jackbh510/IEEE-Audio-Equalizer/Baxandall Tone Circuit Test.asc

C1: cap; 22n
C2: cap; 22n
C3: cap; 1.8n
C4: cap; 220p
R1: res; 5.6k
R2: res; 5.6k
R3: res; {pot1*pot1dev/100}
R4: res; {pot1-pot1*pot1dev/100}
R5: res; 10k
R6: res; 100k
R7: res; {pot2*pot2dev/100}
R8: res; {pot2-pot2*pot2dev/100}
R9: res; 3.3k
R10: res; 3.3k
U1: ADTL082
V1: voltage; ""; AC 1
V2: voltage; 9
V3: voltage; -9
Named nets: 0
.param pot1 100k
;.param pot1dev=1
.param pot2 100k
;.param pot2dev=1
.ac dec 100 10 100k
Output
.step param pot2dev 1 99 10
.step param pot1dev 1 99 10
