jackbh510/IEEE-Audio-Equalizer/LCCircuit.asc

C1: cap; .32µ
C2: cap; 1.308µ
C3: cap; .09µ
C4: cap; 6.8µ
C5: cap; 1µ
C6: cap; 1µ
C7: cap; 1n
L1: ind; 22m; Rser=18
L2: ind; 100m; Rser=82
L3: ind; 4.7m; Rser=7.6
R1: res; 1.8k
R2: res; 1.8k
R3: res; 100
R4: res; {pot1-pot1*pot1dev/100}
R5: res; 155
R6: res; {pot1*pot1dev/100}
R7: res; {pot2*pot2dev/100}
R8: res; {pot2-pot2*pot2dev/100}
R9: res; 180
R10: res; {pot3*pot3dev/100}
R11: res; {pot3-pot3*pot3dev/100}
R12: res; 1.8k
R13: res; 1.8k
R14: res; 8k
R15: res; 8k
R16: res; {pot4*pot4dev/100}
R17: res; 8k
R18: res; 8k
R19: res; {pot4-pot4*pot4dev/100}
R20: res; 150
R21: res; 1.8k
R22: res; 1.8k
R23: res; 680
R24: res; 680
R25: res; 680
R26: res; 680
R27: res; 470
R28: res; 100k
R29: res; 1k
U1: UniversalOpAmp2
U2: UniversalOpAmp2
U3: UniversalOpAmp2
U4: UniversalOpAmp2
U5: UniversalOpAmp2
U6: UniversalOpAmp2
U7: UniversalOpAmp2
U8: UniversalOpAmp2
U9: UniversalOpAmp2
V1: voltage; ""; AC 1
V2: voltage; -16
V3: voltage; 16
Named nets: 0, Vout, 16V, -16V, AC_Input, Vin, Summing_Node, Gyr_Induced_L, Low_Pass
.ac dec 100 10 100k
.param pot1=10k
.param pot1dev=50
;.step param pot1dev 1 99 10
.param pot2=10k
;.step param pot2dev 1 99 10
.param pot2dev=50
.param pot3=10k
.param pot3dev=50
;.step param pot3dev 1 99 10
.param pot4=10k
.param pot4dev=50
;.step param pot4dev 1 99 10
