jackbh510/IEEE-Audio-Equalizer/AudioEqualizerLTSpice/Equalizer/LCCircuit.asc

C1: cap; .33µ
C2: cap; 1µ
C3: cap; .068µ
C4: cap; 1µ
C5: cap; 1µ
C6: cap; 1µ
C7: cap; 1n
C8: polcap; 2200µ
C9: polcap; 2200µ
C10: cap; .1µ
C11: cap; .1µ
C12: polcap; 10µ
C13: polcap; 10µ
C14: cap; .33µ
C15: cap; .022µ
D1: diode; 1N5819
D2: diode; 1N5819
D3: diode; 1N4007
D4: diode; 1N4007
L1: ind; 22m; Rser=80
L2: ind; 100m; Rser=82
L3: ind; 4.7m; Rser=13.6
R1: res; 1.87k
R2: res; 1.87k
R3: res; 100
R4: res; {pot1-pot1*pot1dev/100}
R5: res; 100
R6: res; {pot1*pot1dev/100}
R7: res; {pot2*pot2dev/100}
R8: res; {pot2-pot2*pot2dev/100}
R9: res; 150
R10: res; {pot3*pot3dev/100}
R11: res; {pot3-pot3*pot3dev/100}
R12: res; 1.87k
R13: res; 1.87k
R14: res; 8.06k
R15: res; 8.06k
R16: res; {pot4*pot4dev/100}
R17: res; 7.5k
R18: res; 7.5k
R19: res; {pot4-pot4*pot4dev/100}
R20: res; 150
R21: res; 205k
R22: res; 2.05k
R23: res; 5k
R24: res; 5k
R25: res; 5k
R26: res; 5k
R27: res; 2.74k
R28: res; 100k
R29: res; 1k
R30: res; 2.74k
R31: res; 2.74k
R32: res; 249
R33: res; 249
U1: UniversalOpAmp2
U2: UniversalOpAmp2
U3: UniversalOpAmp2
U4: UniversalOpAmp2
U5: UniversalOpAmp2
U6: UniversalOpAmp2
U7: UniversalOpAmp2
U8: UniversalOpAmp2
U10: LT317A
U12: UniversalOpAmp2
V1: voltage; ""; AC 1
V2: voltage; 15
V3: voltage; -15
V4: voltage; SINE(0 22.6 60); Rser=3
Named nets: 0, Vout, 15V, -15V, AC_Input, Vin, Summing_Node, Gyr_Induced_L, Low_Pass
.ac dec 100 10 30k
.param pot1=10k
.param pot2=10k
.param pot3=10k
.param pot4=10k
.lib NE5532.lib
.save V(vout) I(L1) I(L2) I(L3)
.param x=99

.param pot1dev={x}

.param pot2dev={x}

.param pot3dev={x}

.param pot4dev={x}

.step param x list 1 25 50 75 99
