jackbh510/IEEE-Audio-Equalizer/AudioEqualizerLTSpice/ACtoDC/ACtoRails.asc

C1: polcap; 2200µ
C2: polcap; 2200µ
C3: cap; .1µ
C4: cap; .1µ
C5: polcap; 10µ
C6: polcap; 10µ
D1: diode; 1N5819
D2: diode; 1N5819
D3: diode; 1N4007
D4: diode; 1N4007
R1: res; 220
R2: res; 2.2k
R3: res; 2.2k
R4: res; 220
R7: res; 220
R8: res; 220
U1: LM337
U3: LT317A
V1: voltage; SINE(0 22.6 60); Rser=3
Named nets: 0
.tran 1
