jackbh510/IEEE-Audio-Equalizer/AudioEqualizerKiCad/AudioEqualizer.kicad_pcb

## KiCad design AudioEqualizerKiCad/AudioEqualizer.kicad_pcb (2026-11-12)

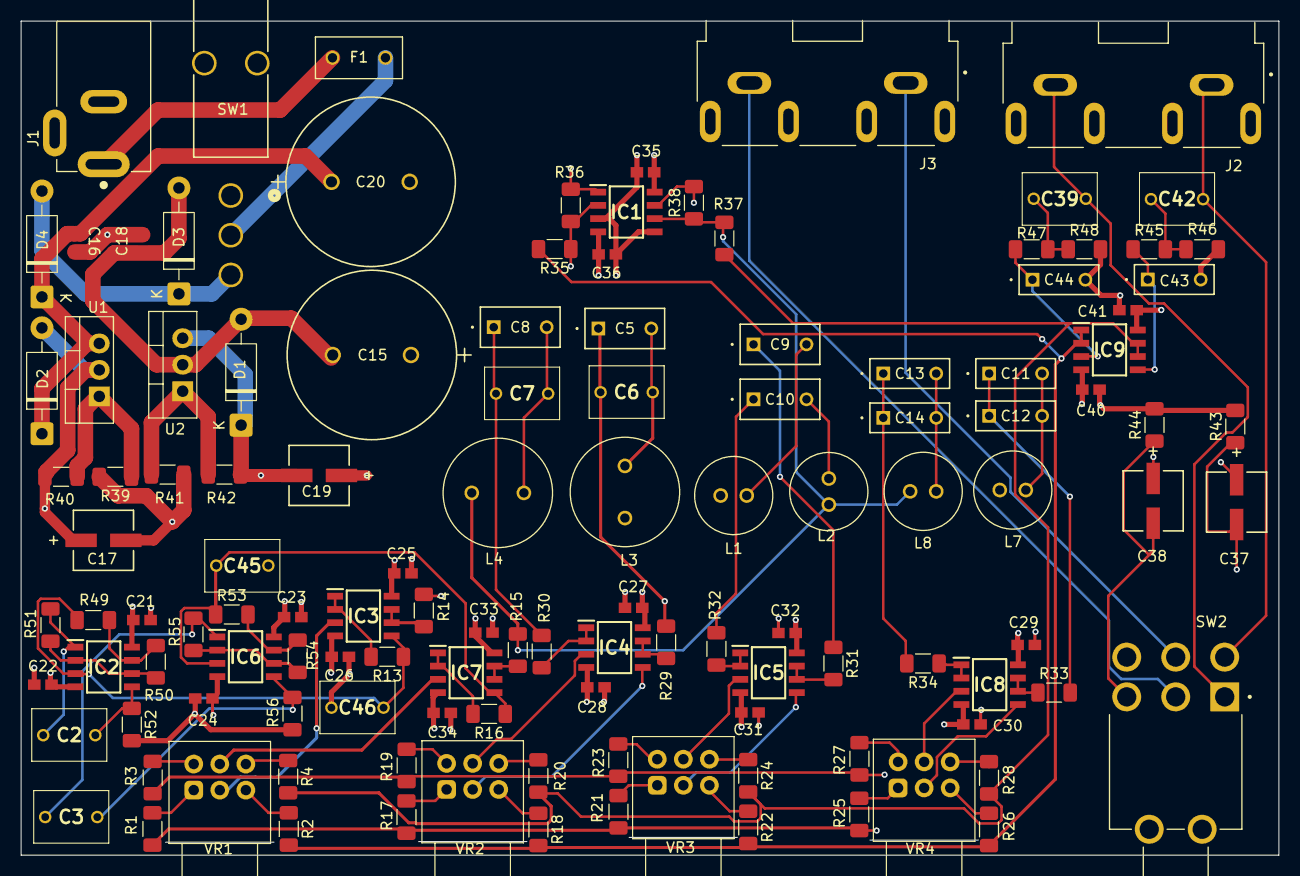
[picture p1: board AudioEqualizer.kicad_pcb from above]

Board: 4 copper layers, 120.7 x 80.0 mm, 123 parts (0 on the bottom side), 82 nets.

Parts:
C2, C3: 1uF; R82DC4100DQ60J
C5, C8, C9, C10: .33u; CAP_R82D-7P4X3P6-5P0_KEM
C6, C7, C39, C42, C45, C46: 1u; R82DC4100DQ60J
C11, C14: 22n; CAP_R82E-7P4X2P6-5P0_KEM
C12, C13: 68n; CAP_R82E-7P4X2P6-5P0_KEM
C15, C20: 2200u; CAP_UAQ_16X25_NCH
C16, C18, C21, C22, C23, C24, C25, C26, C27, C28, C29, C30, C31, C32, C33, C34, C35, C36, C40, C41: .1u; CAPC17595_95N_KEM-M
C17, C19, C37, C38: 10u; PCAP_5x5.4-ELECT_NCA-M
C43, C44: 1n; CAP_R82E-7P4X2P6-5P0_KEM
D1, D2, D3, D4: 1N4002; D_DO-41_SOD81_P10.16mm_Horizontal
F1: 0697H0500-01; FUSRR508W60L835T400H810
IC1, IC2, IC3, IC4, IC5, IC6, IC7, IC8, IC9: NE5532DR; SOIC127P600X175-8N
J1: PJ-002A; CUI_PJ-002A
J2, J3: PJRAN2X1U01AUX; SWITCHCRAFT_PJRAN2X1U01AUX
L1, L2: 22m; IND_DRC-0608-223J-UL
L3, L4: 100m; IND_AISR-01-104J
L7, L8: 4.7m; IND_DRC-0608-472J-UL
R1, R2, R3, R4: 2.05k; R_1206_3216Metric_Pad1.30x1.75mm_HandSolder
R13, R16: 470; R_1206_3216Metric_Pad1.30x1.75mm_HandSolder
R14, R15, R33, R34: 150; R_1206_3216Metric_Pad1.30x1.75mm_HandSolder
R17, R18, R19, R20: 7.5k; R_1206_3216Metric_Pad1.30x1.75mm_HandSolder
R21, R22, R23, R24: 8.06k; R_1206_3216Metric_Pad1.30x1.75mm_HandSolder
R25, R26, R27, R28, R35, R36, R37, R38: 1.87k; R_1206_3216Metric_Pad1.30x1.75mm_HandSolder
R29, R30, R31, R32: 100; R_1206_3216Metric_Pad1.30x1.75mm_HandSolder
R39, R41: 2.74k; R_1206_3216Metric_Pad1.30x1.75mm_HandSolder
R40, R42: 249; R_1206_3216Metric_Pad1.30x1.75mm_HandSolder
R43, R44, R46, R48: 100k; R_1206_3216Metric_Pad1.30x1.75mm_HandSolder
R45, R47: 1k; R_1206_3216Metric_Pad1.30x1.75mm_HandSolder
R49, R50, R51, R52, R53, R54, R55, R56: 5k; R_1206_3216Metric_Pad1.30x1.75mm_HandSolder
SW1: 100SP1T2B4M7QE; SW3_100SP1T2B4M7QE_EWI
SW2: 100DP1T2B4M6QE; SW_100DP1T2B4M6QE
U1: LM317_TO-220; TO-220-3_Vertical
U2: LM337_TO220; TO-220-3_Vertical
VR1, VR2, VR3, VR4: 10k; Potentiometer_Alps_RK097_Dual_Horizontal

Connections:
/Gyrator/15VDC+: C17.1, C21.2, C23.1, C25.1, C27.1, C29.1, C32.1, C33.1, C35.1, C41.1, D2.2 (A), IC1.8 (VCC+), IC2.8 (VCC+), IC3.8 (VCC+), IC4.8 (VCC+), IC5.8 (VCC+), IC6.8 (VCC+), IC7.8 (VCC+), IC8.8 (VCC+), IC9.8 (VCC+), R40.1, U1.2 (VO)
/Gyrator/15VDC-: C19.2, C22.2, C24.1, C26.1, C28.1, C30.1, C31.1, C34.1, C36.1, C40.1, D1.1 (K), IC1.4 (VCC-), IC2.4 (VCC-), IC3.4 (VCC-), IC4.4 (VCC-), IC5.4 (VCC-), IC6.4 (VCC-), IC7.4 (VCC-), IC8.4 (VCC-), IC9.4 (VCC-), R42.2, U2.3 (VO)
/Gyrator/Induced_L_Left: C46.2, IC2.3 (1IN+), IC3.5 (2IN+), R13.1, R49.2
/Gyrator/Induced_L_Right: C45.2, IC6.3 (1IN+), IC7.5 (2IN+), R16.1, R53.1
/RCA(AudioINorOut)/RCA_In_L: C42.2, J2.1_A, SW2.4
/RCA(AudioINorOut)/RCA_In_R: C39.1, J2.1_B, SW2.1
/RCA(AudioINorOut)/RCA_Out_L: C37.2, R43.1, SW2.6
/RCA(AudioINorOut)/RCA_Out_R: C38.2, R44.1, SW2.3
/RLC_Cells/Sum_Left_Vin: IC9.1 (1OUT), IC9.2 (1IN-), R2.2, R18.2, R22.2, R26.2, R35.2
/RLC_Cells/Sum_Left_Vout: C38.1, IC1.1 (1OUT), R1.2, R17.2, R21.2, R25.2, R36.1
/RLC_Cells/Sum_Right_Vin: IC9.6 (2IN-), IC9.7 (2OUT), R4.2, R20.2, R24.2, R28.2, R37.1
/RLC_Cells/Sum_Right_Vout: C37.1, IC1.7 (2OUT), R3.2, R19.2, R23.2, R27.2, R38.2
/RLC_Cells/SummingL: IC1.2 (1IN-), L1.2, L3.2, L7.1, R14.2, R35.1, R36.2
/RLC_Cells/SummingR: IC1.6 (2IN-), L2.2, L4.1, L8.2, R15.2, R37.2, R38.1
GND: C15.1, C16.1, C17.2, C18.2, C19.1, C20.2, C21.1, C22.1, C23.2, C24.2, C25.2, C26.2, C27.2, C28.2, C29.2, C30.2, C31.2, C32.2, C33.2, C34.2, C35.2, C36.2, C40.2, C41.2, C43.2, C44.2, C45.1, C46.1, IC1.3 (1IN+), IC1.5 (2IN+), J1.2, J2.2_A, J2.2_B, J3.2_A, J3.2_B, R39.2, R41.1, R43.2, R44.2, R46.1, R48.2, R52.2, R56.2
unnamed: C5.1, C6.1, R29.2
unnamed: C5.2, C6.2, L3.1
unnamed: C7.1, C8.1, R30.2
unnamed: C7.2, C8.2, L4.2
unnamed: C9.1, R31.1
unnamed: C9.2, L1.1
unnamed: C10.1, R32.1
unnamed: C10.2, L2.1
unnamed: C11.1, C12.1, R33.2
unnamed: C11.2, C12.2, L7.2
unnamed: C13.1, C14.1, R34.2
unnamed: C13.2, C14.2, L8.1
unnamed: C39.2, R47.1, R48.1
unnamed: C42.1, R45.2, R46.2
unnamed: C15.2, C18.1, D1.2 (A), D3.2 (A), U2.2 (VI)
unnamed: C16.2, C20.1, D2.1 (K), D4.1 (K), U1.3 (VI)
unnamed: D3.1 (K), D4.2 (A), SW1.3
unnamed: F1.1, J1.1
unnamed: F1.2, SW1.2
unnamed: IC2.2 (1IN-), IC2.6 (2IN-), R50.1, R51.2
unnamed: C2.1, IC2.1 (1OUT), R51.1
unnamed: C2.2, IC2.5 (2IN+), R52.1
unnamed: IC2.7 (2OUT), R49.1, R50.2
unnamed: IC3.3 (1IN+), VR1.2
unnamed: IC3.1 (1OUT), IC3.2 (1IN-), R13.2
unnamed: IC3.6 (2IN-), IC3.7 (2OUT), R14.1
unnamed: IC4.3 (1IN+), VR2.5
unnamed: IC4.1 (1OUT), IC4.2 (1IN-), R30.1
unnamed: IC4.5 (2IN+), VR2.2
unnamed: IC4.6 (2IN-), IC4.7 (2OUT), R29.1
unnamed: IC5.3 (1IN+), VR3.5
unnamed: IC5.1 (1OUT), IC5.2 (1IN-), R32.2
unnamed: IC5.5 (2IN+), VR3.2
unnamed: IC5.6 (2IN-), IC5.7 (2OUT), R31.2
unnamed: IC6.2 (1IN-), IC6.6 (2IN-), R54.2, R55.1
unnamed: C3.1, IC6.1 (1OUT), R55.2
unnamed: C3.2, IC6.5 (2IN+), R56.1
unnamed: IC6.7 (2OUT), R53.2, R54.1
unnamed: IC7.3 (1IN+), VR1.5
unnamed: IC7.1 (1OUT), IC7.2 (1IN-), R16.2
unnamed: IC7.6 (2IN-), IC7.7 (2OUT), R15.1
unnamed: IC8.3 (1IN+), VR4.5
unnamed: IC8.1 (1OUT), IC8.2 (1IN-), R34.1
unnamed: IC8.5 (2IN+), VR4.2
unnamed: IC8.6 (2IN-), IC8.7 (2OUT), R33.1
unnamed: C44.1, IC9.3 (1IN+), R47.2
unnamed: C43.1, IC9.5 (2IN+), R45.1
unnamed: J3.1_A, SW2.5
unnamed: J3.1_B, SW2.2
unnamed: R1.1, VR1.1
unnamed: R2.1, VR1.3
unnamed: R3.1, VR1.4
unnamed: R4.1, VR1.6
unnamed: R17.1, VR2.1
unnamed: R18.1, VR2.3
unnamed: R19.1, VR2.4
unnamed: R20.1, VR2.6
unnamed: R21.1, VR3.1
unnamed: R22.1, VR3.3
unnamed: R23.1, VR3.4
unnamed: R24.1, VR3.6
unnamed: R25.1, VR4.1
unnamed: R26.1, VR4.3
unnamed: R27.1, VR4.4
unnamed: R28.1, VR4.6
unnamed: R39.1, R40.2, U1.1 (ADJ)
unnamed: R41.2, R42.1, U2.1 (ADJ)
