jackbh510/IEEE-Audio-Equalizer/(commit log)

2026-10-29 Uploading LTSpice Schematics
2026-11-06 LtSpice & KiCad Update
    Added AC to DC dual power rails LTSpice, edited Equalizer LTspice, and added KICad proj with libraries
2026-11-10 Work on KiCAD
    Collected all models that will most likely be used and compiled a basic schematic sketch
2026-11-11 KiCad Update
2026-11-12 KiCAD PCB Update
